BentleySettin/Open-Water-Level/Deployment/3D Part Design/readme.md

**Note:**
The polycase is not actually attached in this photo. This is only to show the 3D part design with the solar panel.
