BentleySettin/Open-Water-Level/Deployment/3D Part Design/OWLRSolarBack.stl

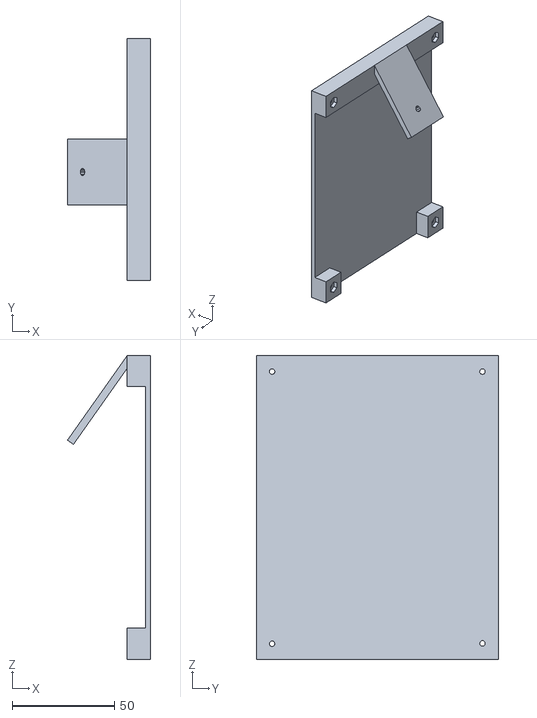
[picture p1: CAD file, 2026-09-03]
Deployment/3D Part Design/OWLRSolarBack.stl
40.7 x 118.5 x 149.0
