BentleySettin/Open-Water-Level/Deployment/3D Part Design/OWLSolarChasis2.stl

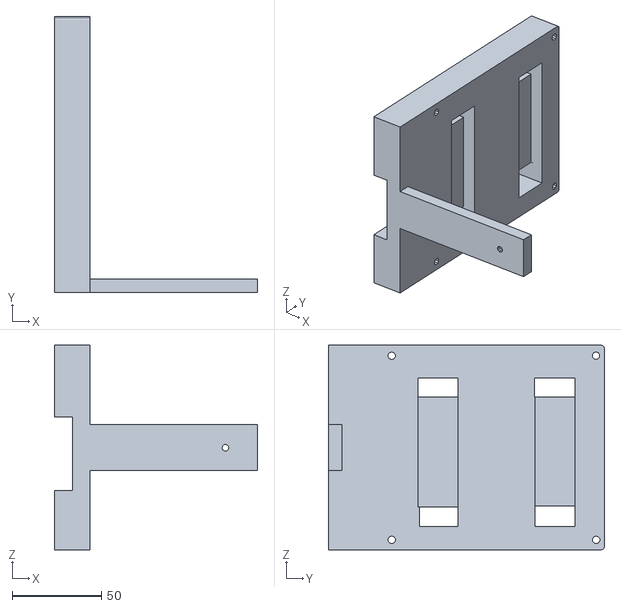
[picture p2: CAD file, 2026-09-03]
Deployment/3D Part Design/OWLSolarChasis2.stl
114.0 x 155.0 x 115.0
