BentleySettin/Open-Water-Level/(commit log)

2026-07-01 Added low power threshold and updated time after publish.
2026-09-03 Add Bill of Materials and deployment instructions
    Added a Bill of Materials and detailed instructions for deployment, including parts, functions, costs, and URLs for sourcing materials.
2026-09-03 Format Bill of Materials and Instructions sections
2026-09-03 Update readme with clarification on 3D part design
    Added a note clarifying that the polycase is not attached in the photo.
